Ashtonantony28/vla-arm/sim/README.md

# sim/ — MuJoCo twin, tasks, scripted experts, LeRobot recording

Everything here is generated from `spec/kinematics.yaml`; nothing in `sim/` hard-codes a link
length, joint limit, mass or servo rating.

## Setup

```bash
cd sim
python3 -m venv .venv                                   # gitignored
.venv/bin/pip install torch torchvision                  # see note on CPU wheels below
.venv/bin/pip install -r requirements.txt                # mujoco, lerobot[dataset,diffusion], pytest, ...
export MUJOCO_GL=egl                                     # offscreen rendering (conftest sets this)
```

What the build machine got (Python 3.13.18, 4 CPU cores, no GPU): mujoco 4.0.0, torch 2.15.0,
torchvision 0.29.2, lerobot 0.7.0 (+ datasets 5.1.0, diffusers 0.39.0, av 15.1.0, torchcodec 0.17.0),
numpy 2.2.6 (lerobot downgraded it from 2.5), gymnasium 1.4.0, pytest 9.2.0.

* `download.pytorch.org` is blocked on that machine, so the CPU-only wheel index was unusable and
  torch came from PyPI (the CUDA build, ~4 GB of `nvidia-*` libraries, runs fine on CPU). On a
  machine with access prefer `--index-url https://download.pytorch.org/whl/cpu`.
* EGL rendering needed `apt-get install libegl1 libegl-mesa0 libgl1-mesa-dri`; OSMesa did not work
  with this mujoco build, so stay with `MUJOCO_GL=egl`.

All commands below run from the repo root with `sim/.venv/bin/python`.

## Model — `sim/model/`

```bash
python -m sim.model.build_mjcf            # regenerate sim/model/vla_arm.xml from the spec
python -m sim.model.build_mjcf --check    # CI: fails if the XML is stale (also a pytest)
```

* Links: capsules/boxes with the spec masses (`masses_kg`; the gripper mass is split palm 70%,
  fingers 15% each). Joint axes, origins, limits from the spec. TCP site at `tool.tcp`.
* Actuators: MuJoCo `position` actuators, `forcerange = ±stall_torque_nm` (2.9 N·m),
  `kp = stall / 0.02 rad` (torque saturates after ~1.1° error, like the servo's P loop),
  critically-damped `kv`, armature 0.01 kg·m² (rotor inertia × gear ratio², ~1:345).
  The env ramps setpoints at sim rate and rate-limits them to the spec `vmax`.
* Gripper: two slide fingers coupled by an equality constraint; the actuator takes the servo angle
  (0 closed … 1.6 rad open) and maps it linearly to 0 … 60 mm jaw gap (`opening_m_at_max`). Its
  force limit is the *continuous* torque (stall × 1.0 A / 2.7 A = 1.07 N·m), on the assumption that
  the firmware limits holding current. TPU-like friction (1.5) on the fingers, elliptic cones.
* Scene: table plane at z = 0 (the base plate stands on it), red/blue 30 mm cubes (30 g, free),
  green/yellow bowls (mocap, repositioned each reset), a cup (free) and a target mark (visual).
  Objects a task doesn't use are parked off-table at x = 3 m.
* Cameras: `wrist` on the gripper body (behind the palm, pitched 40° toward the jaws, fovy 80) and
  a fixed `scene` camera front-right of the arm.
* Tests check: XML up to date, masses, zero-pose TCP = (0.490, 0, 0.100), each actuator moves its
  own joint in the documented positive direction (yaw +x→+y, pitch down, roll right-hand about x,
  gripper positive opens), FK (`sim/kinematics.py`) == MuJoCo, closed-form top-down IK round trip.

## Env — `sim/envs/`

```python
from sim.envs.tabletop import TabletopEnv
env = TabletopEnv("pick_place", image_size=96)          # "stack", "sort"; image_size int or (h, w)
obs, info = env.reset(seed=0)
obs, reward, terminated, truncated, info = env.step(action6)
```

* Observation: `observation.state` (6 joint positions, rad, order
  base_yaw, shoulder_pitch, elbow_pitch, wrist_pitch, wrist_roll, gripper),
  `observation.images.wrist|scene` (uint8 HxWx3), `task` (instruction string).
* Action: 6 absolute joint targets at 30 Hz; 20 physics substeps (dt = 1/600 s) in between.
* Tasks (`sim/envs/tasks.py`) with 5 paraphrases each; the first 3 are used for data, the last 2 are
  held out (`instruction_split="heldout"`):
  * `pick_place` — red block into the (green) bowl; blue block is a distractor.
  * `stack` — red block on the blue block.
  * `sort` — red and blue into the green/yellow bowls; the colour→bowl assignment is random and
    only given by the instruction (so the task needs language).
  * 30% of resets also place the cup and/or the target mark as distractors.
* Success: block centre inside the bowl's inner radius and below the rim; or red on blue within
  15 mm xy and 30 ± 6 mm z with blue on the table. In every case the block must not be touching
  the fingers (it was released).

## Domain randomisation — `sim/envs/randomization.py`

```python
env = TabletopEnv("pick_place", image_size=96, randomize="default")   # or "visual", a dict, a DRConfig
```

Applied at every `reset` by editing `MjModel` fields in place (no XML change):

| group | what | range (preset `default`) |
|---|---|---|
| lighting | key-light direction tilt, key / fill intensity, colour temperature, headlight | ≤ 25°, ×0.55–1.35, ×0.4–1.6, ±12 % per channel, ambient 0.2–0.5 / diffuse 0.3–0.65 |
| colours / textures | table tint (saturation ≤ 0.22 so it never reads as a task colour), checker repeat, arm shade; objects jittered **inside their colour class** (red H ±0.025, blue 0.58–0.66, green 0.29–0.40, yellow 0.12–0.16); cup / target random low-saturation | repeat 3–10, shade ×0.75–1.3 |
| camera | position jitter and rotation about a random axis | scene ±5 mm / ±2°, wrist ±2 mm / ±1.5° |
| action noise | Gaussian on the 5 arm joint targets inside `step` (the recorded action is the clean command, DART-style) | σ = 4 mrad (`visual` preset: 0) |

* DR draws come from their own streams seeded from the reset seed (`[seed, 0xD12]`, `[seed, 0xAC7]`),
  so for a given seed the **layout and instruction are identical with or without DR** — every
  policy and every DR setting is evaluated on the same start poses.
* All draws happen even for disabled groups, so toggling one group does not change the others.
* `env.dr_params` holds what was drawn (also saved per episode in `meta/sim_episodes.jsonl`).
* Tests (`sim/tests/test_randomization.py`): same seed → identical images/params, layouts
  independent of DR, nominal env untouched, colours stay in class over 60 seeds, camera/light
  bounds, seeded action noise, toggles independent.
* The experts are unaffected: `python -m sim.expert.evaluate --episodes 40 --randomize default`
  → pick_place / stack / sort 40/40 each (Wilson 95 % CI 91–100 %).

Contact sheet (rows: DR pick_place, DR sort, nominal; seeds 900000–900005):
`outputs/wave2/viz/dr_sheet.png` (not in git).

## Scripted experts — `sim/expert/`

Privileged-state experts: Cartesian waypoints (approach → descend → close → lift → transfer → lower
→ open → retreat), min-jerk interpolation, closed-form IK, jaw aligned to the nearest cube face,
noise on waypoints (2–4 mm), segment durations (±15%) and joint targets (σ = 0.002 rad).

```bash
python -m sim.expert.evaluate --episodes 100
```

Result (seeds 0–99): pick_place 100/100, stack 100/100, sort 100/100
(Wilson 95% CI 96–100% each); mean 168 / 168 / 356 steps.

## Recording — `sim/record.py`

```bash
python -m sim.record --task all --episodes 30 --image-size 96 --overwrite
# wave 2: domain-randomised data (two halves recorded in parallel, plus a validation set)
python -m sim.record --task pick_place --episodes 50 --randomize default --root outputs/wave2/datasets --name-suffix _dr_a
python -m sim.record --task pick_place --episodes 50 --randomize default --seed0 1000 --root outputs/wave2/datasets --name-suffix _dr_b
python -m sim.record --task pick_place --episodes 10 --randomize default --seed0 950000 --root outputs/wave2/datasets --name-suffix _dr_val
```

Uses LeRobot's own `LeRobotDataset.create / add_frame / save_episode / finalize` (dataset format
**v3.0**: chunked parquet + AV1 MP4 per camera, `meta/info.json`, `meta/stats.json`,
`meta/tasks.parquet`, `meta/episodes/`). Extra sidecars: `meta/sim_episodes.jsonl` (seed, layout,
instruction per episode) and `meta/sim_record_summary.json`. Only successful episodes are kept;
10 frames after success are kept so policies learn to stop. Recording seeds start at 0, eval
seeds at 900 000.

Recorded on the build machine into `outputs/datasets/` (gitignored), 96×96:

| dataset | episodes | frames | size | time |
|---|---|---|---|---|
| vla_arm_sim_pick_place | 30 | 5 333 | 11.4 MB | 4.6 min |
| vla_arm_sim_stack | 30 | 5 332 | 10.1 MB | 4.1 min |
| vla_arm_sim_sort | 30 | 11 014 | 25.1 MB | 10.3 min |

Wave 2, domain-randomised (`--randomize default`), into `outputs/wave2/datasets/` (times are with
3 recorders sharing the CPU; EGL uses llvmpipe software rendering here, ~1.1 cores per recorder):

| dataset | episodes (seeds) | frames | size | time |
|---|---|---|---|---|
| vla_arm_sim_pick_place_dr_a | 50 (0–49) | 8 899 | 17.3 MB | 15.7 min |
| vla_arm_sim_pick_place_dr_b | 50 (1000–1049) | 8 899 | 17.1 MB | 15.8 min |
| vla_arm_sim_pick_place_dr_val | 10 (950000–) | 1 800 | 3.5 MB | 3.0 min |
| vla_arm_sim_pick_place_val (nominal) | 10 (950000–) | 1 799 | 3.9 MB | 3.1 min |
| vla_arm_sim_sort_dr | 100 (0–99) | 36 648 | 76.6 MB | 65.8 min |

(`vla_arm_sim_pick_place_dr` in that folder is an aborted, unfinalised recording; ignore it.)

## Tests

```bash
sim/.venv/bin/python -m pytest -q sim/tests policies/tests
```

## Real vs simplified

* Real: geometry, limits, masses, stall torque, vmax from the spec; contact physics; cameras.
* Simplified: link shapes are primitives; servo = ideal saturating PD (no backlash, deadband,
  compliance, temperature); gripper linkage is linear; the expert uses privileged object poses;
  bowls are fixed during an episode; domain randomisation covers lighting, colours, camera pose
  and action noise but not object size/mass/friction, textures beyond a tinted checker, or
  camera intrinsics.
