Ashtonantony28/vla-arm/hardware/board/out/erc_report.md

# Board ERC report (generated by `python -m board.generate`)

Netlist: 139 parts, 68 nets, 358 pin connections, 9 ICs.

## Own ERC (board/erc.py): 0 errors, 7 warnings

- no errors
- warning R5: UNVERIFIED mapping PB14 = USART3_DE (RTS/DE, DEM=1) (AF7): hardware driver-enable: high during TX; drives both buffer OEs. If not available, use PB14 as GPIO toggled in the TC interrupt
- warning R5: UNVERIFIED mapping PA11 = USB_DM (USB (fixed pin)): USB FS pins are fixed; confirm in RM0440 whether an AF selection is needed (CubeMX does it)
- warning R5: UNVERIFIED mapping PA12 = USB_DP (USB (fixed pin)): internal DP pull-up, no external 1.5k
- warning R5: UNVERIFIED mapping PB12 = FDCAN2_RX (AF9): FDCAN1 is avoided: PA11/12 clash with USB, PB8 is BOOT0 (CAN RXD idles high -> would boot ROM)
- warning R5: UNVERIFIED mapping PB13 = FDCAN2_TX (AF9): 
- warning R5: UNVERIFIED mapping PC0 = ADC12_IN6 (analog): board NTC
- warning R5: UNVERIFIED mapping PC1 = ADC12_IN7 (analog): protected 12 V divider 100k/15k

## SKiDL built-in ERC: 0 errors, 26 warnings

- 26 warnings = unused STM32 GPIOs left unconnected (intended; spare pins, route to a header or leave as NC in KiCad)

## BOM lines needing a human check: 22 of 89

- C3 C4 C39 C40: Electrolytic 470 uF 25 V low-ESR, radial 10 mm -> Panasonic EEU-FR1E471 [verify]
- D6: ESD/TVS 5 V unidirectional (servo data line) -> Nexperia PESD5V0S1BL [verify]
- D7: Zener 15 V gate clamp -> Diodes Inc BZT52C15-7-F [verify]
- D9: CAN bus ESD protection -> Nexperia PESD2CAN,215 [verify]
- F1: Fuse 15 A slow-blow, >= 32 V (or blade fuse in the PSU lead) ->  (no part chosen) [TBD]
- J1: 12 V input, XT30 PCB male (rated 15 A+) -> Amass XT30PW-M [verify]
- J2: Cortex-M 10-pin SWD header 1.27 mm -> Samtec FTSH-105-01-F-DV-K [verify]
- J4: USB-C receptacle, USB 2.0 device -> GCT USB4105-GF-A [verify]
- J5: Servo bus port, 3-pin (match the servo cable: pin order and housing MUST be checked against the STS3215 lead) ->  (no part chosen) [TBD]
- J6: Servo bus port, 3-pin (match the servo cable: pin order and housing MUST be checked against the STS3215 lead) ->  (no part chosen) [TBD]
- J7: Servo bus port, 3-pin (match the servo cable: pin order and housing MUST be checked against the STS3215 lead) ->  (no part chosen) [TBD]
- J9: CAN-FD port (v2), JST-GH 3p -> JST SM03B-GHS-TB(LF)(SN) [verify]
- L1: Inductor ~10 uH, Isat >= 4 A, DCR < 40 mOhm (TPS54331 5 V/3 A) ->  (no part chosen) [TBD]
- L2: Inductor 2.2 uH, Isat >= 1.5 A -> Murata DFE201610E-2R2M [verify]
- Q1: N-MOSFET 30 V, < 3 mOhm, SON5x6 (ideal-diode pass FET) -> TI CSD17573Q5B [verify]
- Q2: P-MOSFET -40 V, ~15 mOhm, Id >= 30 A, DPAK (servo power switch) -> Alpha & Omega AOD4185 [verify]
- Q3 Q4: N-MOSFET logic level 50 V 200 mA SOT-23 -> onsemi BSS138LT1G [verify]
- R_SH: Current shunt 3 mOhm 1 % 2 W 2512, Kelvin pads -> Vishay WSL2512R0030FEA [verify]
- SW1: Tactile switch SMD -> C&K PTS810SJM250SMTRLFS [verify]
- SW2: Tactile switch SMD -> C&K PTS810SJM250SMTRLFS [verify]
- U9: CAN-FD transceiver with VIO (8 Mbps, SIC) - v2 joint modules -> TI TCAN1462VDRQ1 [verify]
- Y1: Crystal 24 MHz, CL 8-10 pF, +-20 ppm, 3225 -> Abracon ABM8-24.000MHZ-B2-T [verify]
