Ashtonantony28/vla-arm/hardware/cad/out/cad_report.md

# CAD check report (generated by `python -m cad.build`; do not edit)

Generated 2026-11-06. All numbers come from the generated B-rep, not from hand calculation. Nothing here has been printed or measured.

## Printed parts

| part | link | mat | valid closed solid | volume cm3 | est. mass g | bbox mm | fits 220x220x250 | min wall mm (1st pct) | STL kB |
|---|---|---|---|---|---|---|---|---|---|
| base | base | PETG | yes | 233.2 | 118.5 | 140 x 190 x 40 | yes (height 140.0 mm, footprint 190.0 x 39.6 rotated 0.0 deg) | 2.00 (3.45) | 108 |
| shoulder_bracket | shoulder | PETG | yes | 85.7 | 43.6 | 72 x 72 x 117 | yes (height 72.0 mm, footprint 72.1 x 117.4 rotated 0.0 deg) | 2.30 (2.30) | 153 |
| upper_arm | upper_arm | PETG | yes | 85.7 | 43.5 | 252 x 62 x 52 | yes (height 62.0 mm, footprint 251.8 x 52.1 rotated 43.0 deg) | 2.50 (2.50) | 175 |
| forearm | forearm | PETG | yes | 76.7 | 39.0 | 232 x 50 x 52 | yes (height 231.8 mm, footprint 50.0 x 52.0 rotated 0.0 deg) | 2.50 (2.50) | 188 |
| wrist_bracket | wrist | PETG | yes | 28.2 | 14.3 | 71 x 49 x 52 | yes (height 71.0 mm, footprint 49.1 x 52.1 rotated 0.0 deg) | 2.70 (2.72) | 158 |
| gripper_body | gripper | PETG | yes | 40.1 | 20.4 | 46 x 80 x 72 | yes (height 46.0 mm, footprint 80.0 x 72.4 rotated 0.0 deg) | 2.00 (2.50) | 42 |
| camera_mount | gripper | PETG | yes | 18.6 | 9.4 | 28 x 36 x 34 | yes (height 28.0 mm, footprint 36.0 x 34.0 rotated 0.0 deg) | 2.90 (2.91) | 80 |
| pinion | grip_drive | PETG | yes | 7.1 | 3.6 | 7 x 40 x 40 | yes (height 7.0 mm, footprint 40.4 x 40.5 rotated 0.0 deg) | 2.70 (2.72) | 82 |
| jaw_a | jaw_a | PETG | yes | 6.2 | 3.2 | 37 x 44 x 22 | yes (height 37.0 mm, footprint 44.0 x 21.9 rotated 0.0 deg) | 6.00 (6.00) | 9 |
| jaw_b | jaw_b | PETG | yes | 13.9 | 7.1 | 37 x 44 x 66 | yes (height 37.0 mm, footprint 44.0 x 65.9 rotated 0.0 deg) | 6.00 (6.00) | 9 |
| pad_a | jaw_a | TPU | yes | 0.8 | 1.0 | 20 x 2 x 20 | yes (height 20.0 mm, footprint 2.0 x 20.0 rotated 0.0 deg) | 2.00 (2.00) | 1 |
| pad_b | jaw_b | TPU | yes | 0.8 | 1.0 | 20 x 2 x 20 | yes (height 20.0 mm, footprint 2.0 x 20.0 rotated 0.0 deg) | 2.00 (2.00) | 1 |

Total printed mass estimate: **304 g** (PETG 1.27 g/cm3 x 40% effective solid fraction; TPU pads solid).

## Link masses vs spec (g)

| link | printed | servos + purchased | total | spec | delta |
|---|---|---|---|---|---|
| base | 118 | 165 | 283 | 350 | -67 |
| shoulder | 44 | 55 | 99 | 110 | -11 |
| upper_arm | 44 | 55 | 99 | 140 | -41 |
| forearm | 39 | 55 | 94 | 120 | -26 |
| wrist | 14 | 0 | 14 | 75 | -61 |
| gripper | 46 | 125 | 171 | 110 | +61 |
| **all** | | | **760** | **905** | -145 |

Note: in this design the wrist-roll servo CASE rides in the gripper (its horn is bolted to the wrist bracket), so mass moves from `wrist` to `gripper`; wrist+gripper = 185 g vs spec 185 g. Fasteners, wiring and heat-set inserts are not included (budget +5-10 % per link).

## Joint-axis distances measured from part geometry

| feature pair | measured mm | spec mm | error mm |
|---|---|---|---|
| base: plate -> yaw horn face | 40.000 | 40.000 | +0.000 |
| shoulder bracket: yaw horn face -> shoulder axis | 60.000 | 60.000 | +0.000 |
| upper_arm: proximal bore axis -> distal stub axis | 200.000 | 200.000 | +0.000 |
| forearm: proximal bore axis -> distal stub axis | 180.000 | 180.000 | +0.000 |
| wrist bracket: pitch axis -> roll horn face | 45.000 | 45.000 | +0.000 |
| gripper: roll horn face -> TCP (pad centre) | 65.000 | 65.000 | +0.000 |

## Collision-free joint ranges (one joint swept, others at zero)

Adjacent = parent/child parts across the swept joint (incl. servo cases, horns, bearing). All = every part downstream of the joint vs every part upstream.

| joint | spec limits rad | adjacent-pair free range | all-pairs free range | within spec? |
|---|---|---|---|---|
| base_yaw | [-2.60, +2.60] | [-2.600, +2.600] | [-2.600, +2.600] | yes |
| shoulder_pitch | [-1.80, +1.30] | [-1.800, +0.843] | [-1.800, +0.802] | **NO** |
| elbow_pitch | [-2.70, +2.70] | [-2.700, +2.700] | [-2.700, +2.363] | yes |
| wrist_pitch | [-1.90, +1.90] | [-1.900, +1.900] | [-1.900, +1.900] | yes |
| wrist_roll | [-3.00, +3.00] | [-3.000, +3.000] | [-3.000, +3.000] | yes |
| gripper | [+0.00, +1.60] | [+0.000, +1.600] | [+0.000, +1.600] | yes |

Shoulder: with the shoulder axis only 100 mm above the plate (spec) and the base housing the yaw servo under a 78 mm bearing, the upper arm reaches the base/turntable at about +0.80 rad (46 deg down); the spec limit +1.30 rad is not mechanically reachable. Elbow: folding down past ~+2.36 rad with the shoulder at zero drives the wrist into the base (a pose-dependent self-collision for the host-side checker, not an adjacent-part clash).
