Ashtonantony28/vla-arm/hardware/cad/out/camera_mount.stl

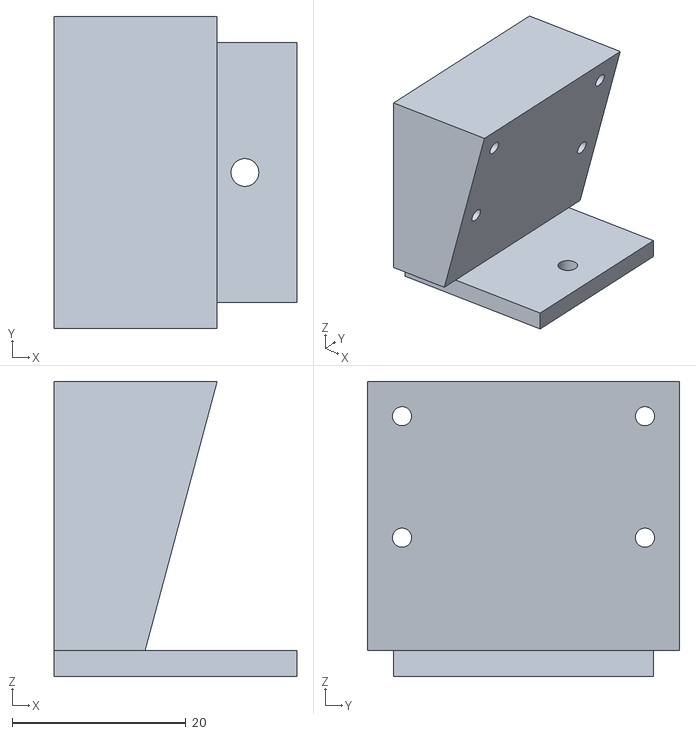
[picture p1: CAD file, 2026-11-06]
hardware/cad/out/camera_mount.stl
28.0 x 36.0 x 34.0
