Ashtonantony28/vla-arm/hardware/cad/out/upper_arm.stl

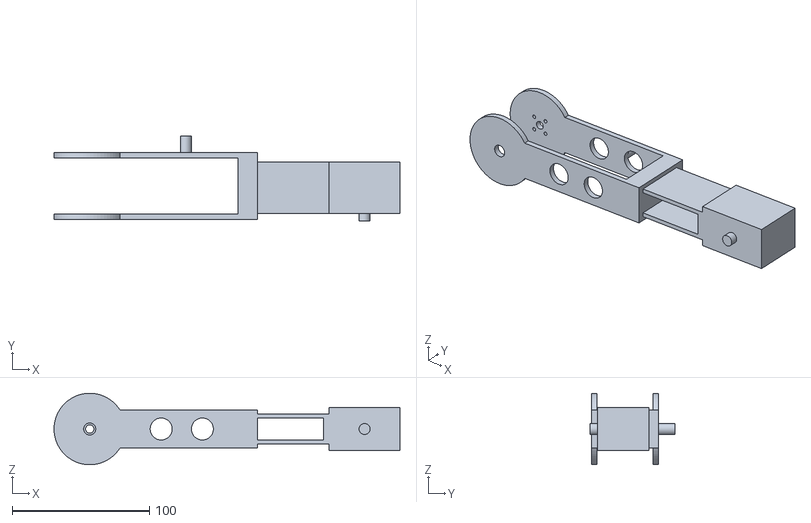
[picture p2: CAD file, 2026-11-06]
hardware/cad/out/upper_arm.stl
251.8 x 62.0 x 52.0
