Ashtonantony28/vla-arm/hardware/cad/out/shoulder_bracket.stl

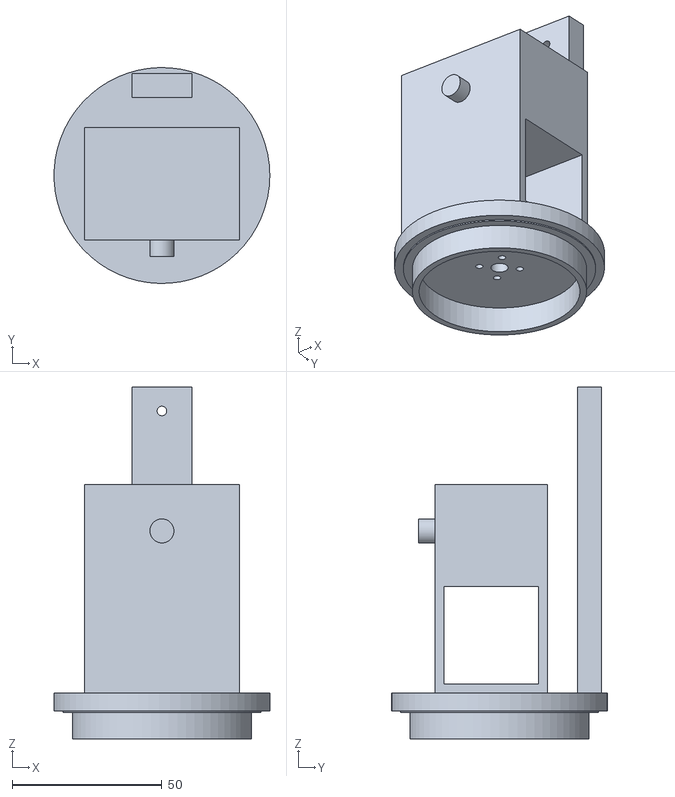
[picture p3: CAD file, 2026-11-06]
hardware/cad/out/shoulder_bracket.stl
72.0 x 72.0 x 117.4
