Ashtonantony28/vla-arm/hardware/cad/out/pad_a.stl

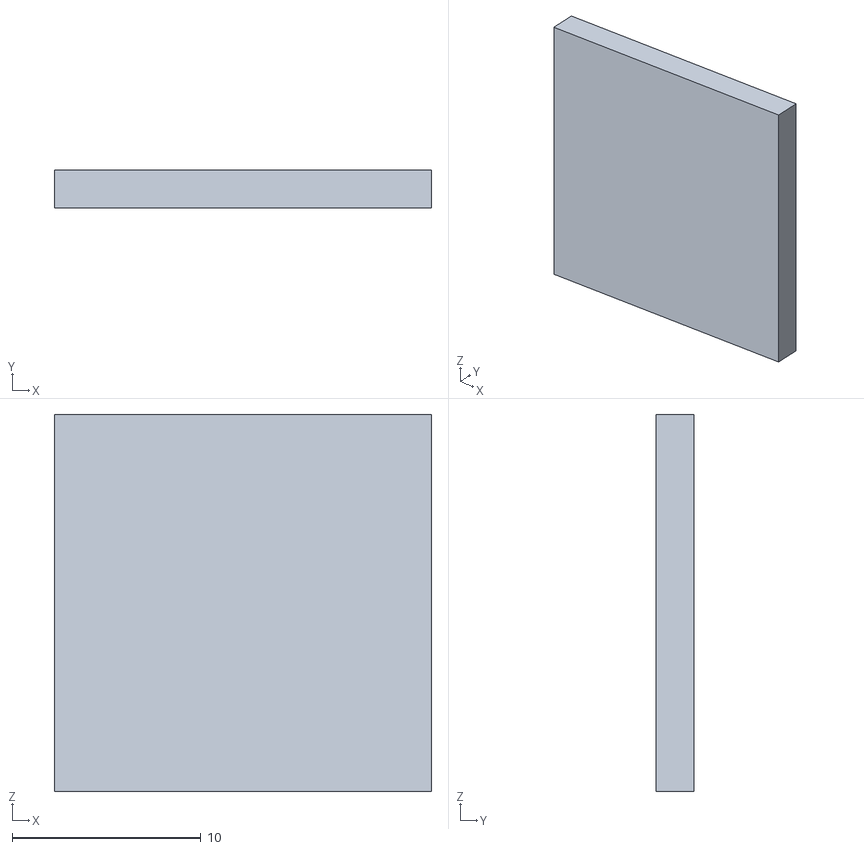
[picture p4: CAD file, 2026-11-06]
hardware/cad/out/pad_a.stl
20.0 x 2.00 x 20.0
