Ashtonantony28/vla-arm/hardware/cad/out/wrist_bracket.stl

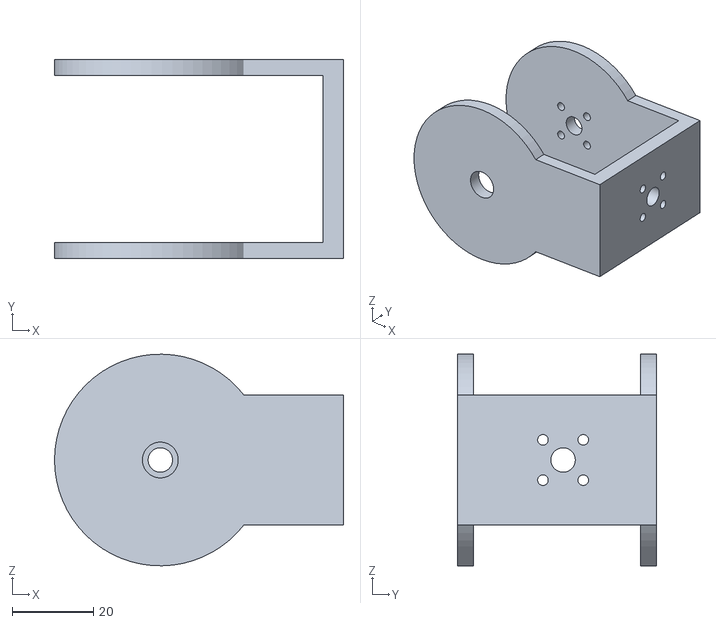
[picture p5: CAD file, 2026-11-06]
hardware/cad/out/wrist_bracket.stl
71.0 x 49.0 x 52.0
