Ashtonantony28/vla-arm/hardware/cad/out/jaw_b.stl

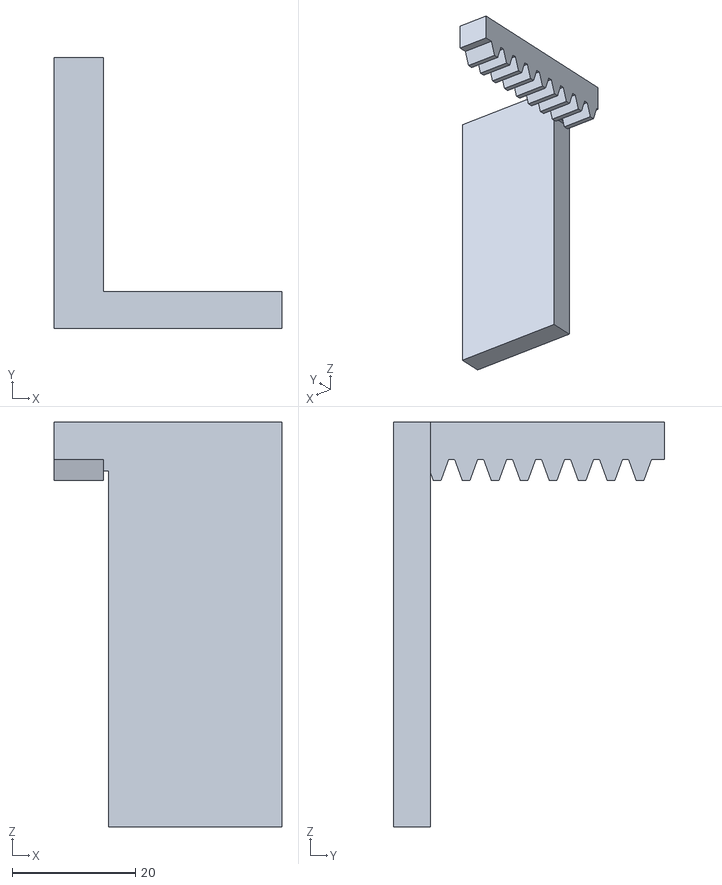
[picture p6: CAD file, 2026-11-06]
hardware/cad/out/jaw_b.stl
37.0 x 44.0 x 65.8
