Ashtonantony28/vla-arm/hardware/cad/out/pinion.stl

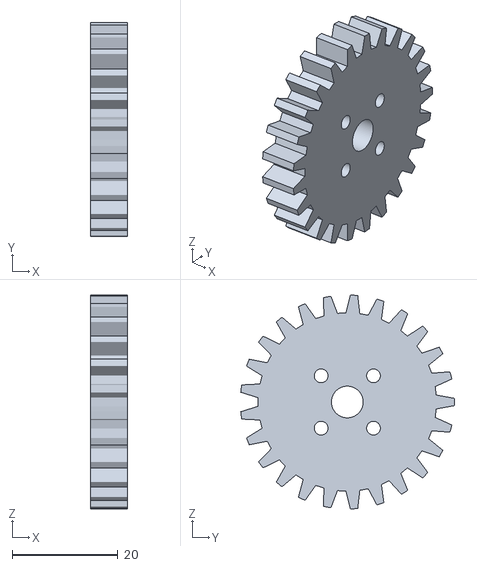
[picture p7: CAD file, 2026-11-06]
hardware/cad/out/pinion.stl
7.00 x 40.4 x 40.5
