Ashtonantony28/vla-arm/hardware/cad/out/forearm.stl

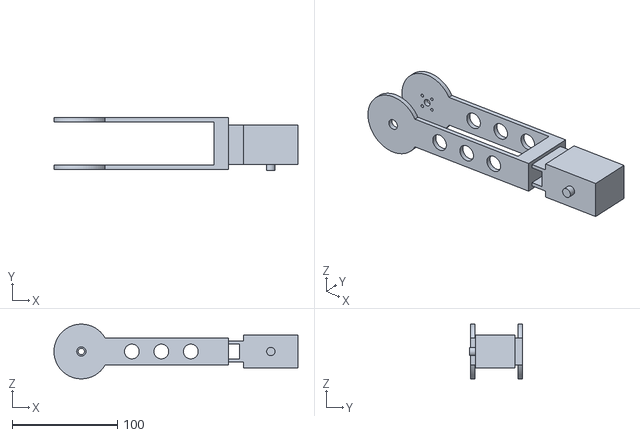
[picture p8: CAD file, 2026-11-06]
hardware/cad/out/forearm.stl
231.8 x 50.0 x 52.0
