Ashtonantony28/vla-arm/hardware/cad/out/base.stl

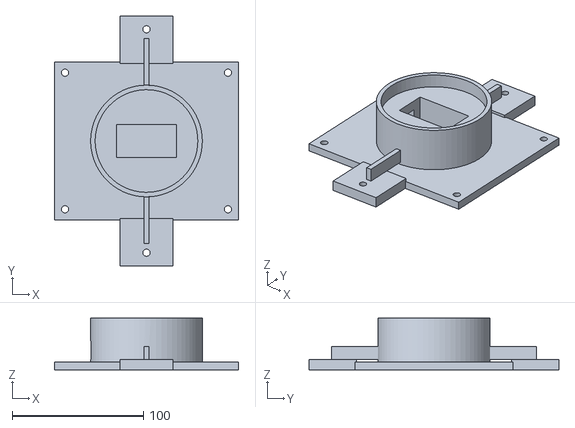
[picture p9: CAD file, 2026-11-06]
hardware/cad/out/base.stl
140.0 x 190.0 x 39.5
