Ashtonantony28/vla-arm/hardware/cad/out/gripper_body.stl

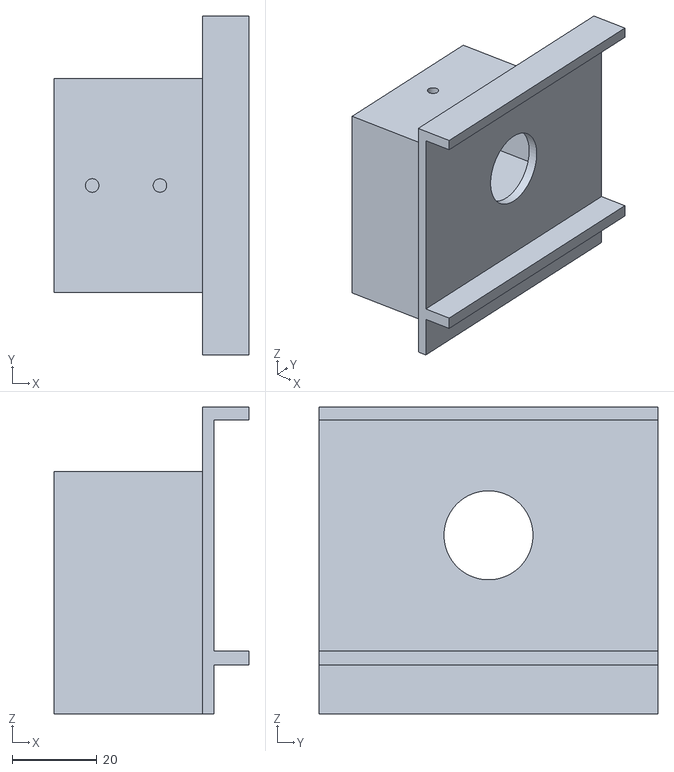
[picture p10: CAD file, 2026-11-06]
hardware/cad/out/gripper_body.stl
46.0 x 80.0 x 72.4
