Ashtonantony28/vla-arm/hardware/cad/out/jaw_a.stl

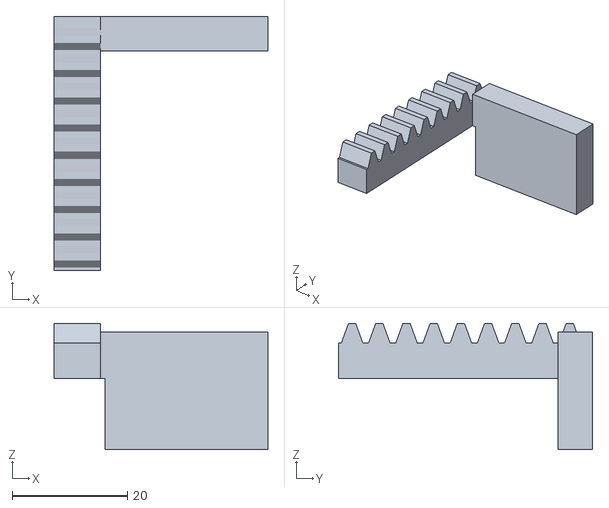
[picture p11: CAD file, 2026-11-06]
hardware/cad/out/jaw_a.stl
37.0 x 44.0 x 21.9
