Ashtonantony28/vla-arm/(list of files, cad)

Other CAD files:
hardware/cad/out/pad_b.stl
