Ashtonantony28/vla-arm/firmware/targets/stm32g474/tusb_config.h

/* TinyUSB configuration: device only, full speed, one CDC-ACM interface (the host link). */
#ifndef TUSB_CONFIG_H
#define TUSB_CONFIG_H

#define CFG_TUSB_MCU OPT_MCU_STM32G4
#define CFG_TUSB_OS OPT_OS_NONE
#define CFG_TUSB_DEBUG 0
#define CFG_TUSB_MEM_SECTION
#define CFG_TUSB_MEM_ALIGN __attribute__((aligned(4)))

#define BOARD_TUD_RHPORT 0
#define CFG_TUD_ENABLED 1
#define CFG_TUD_MAX_SPEED OPT_MODE_FULL_SPEED
#define CFG_TUD_ENDPOINT0_SIZE 64

#define CFG_TUD_CDC 1
#define CFG_TUD_MSC 0
#define CFG_TUD_HID 0
#define CFG_TUD_MIDI 0
#define CFG_TUD_VENDOR 0

/* CDC FIFOs inside TinyUSB. The firmware's own rings (host_link) sit behind these. */
#define CFG_TUD_CDC_RX_BUFSIZE 512
#define CFG_TUD_CDC_TX_BUFSIZE 1024
#define CFG_TUD_CDC_EP_BUFSIZE 64

#endif
