Ashtonantony28/vla-arm/hardware/tests/test_cad.py

"""Automated checks on the generated CAD (geometry from the B-rep, kinematics from spec/)."""
import numpy as np
import pytest

from cad import assembly as A
from cad import checks as C
from cad import params as P
from cad import parts as PT
from spec_loader import load_spec

PRINTED = list(PT.PRINTED)


@pytest.mark.parametrize("teeth", [False, True])
@pytest.mark.parametrize("name", PRINTED)
def test_part_is_single_valid_closed_solid(name, teeth):
    r = C.solid_report(PT.build_printed(name, teeth))
    assert r["n_solids"] == 1 and r["valid"] and r["closed"] and r["volume"] > 0


@pytest.mark.parametrize("name", PRINTED)
def test_part_fits_print_bed(name):
    ok, how = C.fits_bed(PT.build_printed(name, teeth=True))
    assert ok, how


@pytest.mark.parametrize("name", PRINTED)
def test_min_wall_thickness(name):
    # pitch-envelope variant: gear teeth are excluded from the 2 mm rule by design
    wt = C.wall_thickness(PT.build_printed(name, teeth=False))
    assert wt["min"] >= P.WALL_MIN - 0.01, wt


def test_measured_joint_distances_match_spec():
    for k, (meas, spec) in C.measured_dimensions().items():
        assert abs(meas - spec) <= 0.5, (k, meas, spec)


def test_assembled_axes_match_spec_fk():
    """Place each part's measured axis features with the spec FK and compare consecutive distances."""
    spec = load_spec()
    pts = C.assembled_axes({})
    chain = ["shoulder_pitch", "elbow_pitch", "wrist_pitch", "wrist_roll", "tcp"]
    expected = [200.0, 180.0, 45.0, 65.0]
    for (a, b), e in zip(zip(chain, chain[1:]), expected):
        pa, pb = pts[a].copy(), pts[b].copy()
        pa[1] = pb[1] = 0.0          # pitch stubs sit on the idler side (y offset), axes are along y
        assert abs(np.linalg.norm(pb - pa) - e) <= 0.5, (a, b)
    # shoulder axis height above the base plate
    assert abs(pts["shoulder_pitch"][2] - 100.0) <= 0.5
    # also in a non-trivial pose: TCP from parts == TCP from spec chain
    q = {"base_yaw": 0.7, "shoulder_pitch": -0.6, "elbow_pitch": 1.1, "wrist_pitch": 0.4, "wrist_roll": 1.0}
    p = C.assembled_axes(q)
    assert np.allclose(p["tcp"], A.tcp_world(q), atol=0.5)


def test_tcp_zero_pose_matches_spec():
    s = load_spec()
    x = 1000 * (sum(j["origin"][0] for j in s["joints"]) + s["tool"]["tcp"][0])
    z = 1000 * sum(j["origin"][2] for j in s["joints"])
    assert np.allclose(A.tcp_world({}), [x, 0, z], atol=1e-6)


def test_gripper_opening_matches_spec():
    """Pad-to-pad gap measured from posed parts at full open equals spec opening_m_at_max."""
    hi = load_spec()["gripper"]["limits"][1]
    pads = {it.name: s for it, s in A.posed({"gripper": hi}) if it.name in ("pad_a", "pad_b")}
    gap = pads["pad_a"].BoundingBox().ymin - pads["pad_b"].BoundingBox().ymax
    assert gap == pytest.approx(1000 * load_spec()["gripper"]["opening_m_at_max"], abs=0.5)


def test_zero_pose_no_interference_any_pair():
    assert A.collisions({}, adjacent_only=False) == []


@pytest.mark.parametrize("jn", ["base_yaw", "elbow_pitch", "wrist_pitch", "wrist_roll", "gripper"])
def test_sweep_spec_limits_adjacent_clear(jn):
    bad = [(q, h) for q, h in C.sweep(jn, n=13, adjacent_only=True) if h]
    assert not bad, bad


def test_shoulder_sweep_clear_within_mechanical_range():
    lo = C.joint_limits()["shoulder_pitch"][0]
    for q in np.linspace(lo, 0.80, 14):
        assert A.collisions({"shoulder_pitch": q}, C.moving_set("shoulder_pitch"), adjacent_only=False) == [], q


# spec v1.1 lowered shoulder max to +0.75 rad (was +1.30, which hit the base at ~+0.80)
def test_shoulder_sweep_spec_limits_adjacent_clear():
    bad = [(q, h) for q, h in C.sweep("shoulder_pitch", n=13, adjacent_only=True) if h]
    assert not bad


def test_sweep_all_pairs_known_self_collisions_only():
    """Non-adjacent clashes during single-joint sweeps are limited to the known pose-dependent ones."""
    for jn in ("base_yaw", "wrist_pitch", "wrist_roll", "gripper"):
        assert all(not h for _, h in C.sweep(jn, n=9, adjacent_only=False)), jn
    lo, hi = C.free_range("elbow_pitch", adjacent_only=False)
    assert lo == C.joint_limits()["elbow_pitch"][0] and 2.2 < hi < 2.7


def test_pinion_tangent_to_racks_over_stroke():
    """Pitch-envelope pinion stays tangent (no overlap, no gap > 0.05 mm) to both racks over the stroke."""
    def rack_face(shape, x_max, up):
        zs = [f.Center().z for f in shape.Faces() if f.geomType() == "PLANE" and f.BoundingBox().xmin < x_max
              and f.normalAt(f.Center()).z * (1 if up else -1) > 0.99]
        return max(zs) if up else min(zs)
    for qg in np.linspace(0, 1.6, 5):
        q = {"gripper": qg}
        x_max = A.link_transforms(q)["gripper"][0, 3] + P.RACK_X[1] - 0.5
        posed = {it.name: s for it, s in A.posed(q)}
        pin = posed["pinion"].BoundingBox()
        assert rack_face(posed["jaw_a"], x_max, up=True) == pytest.approx(pin.zmin, abs=0.05)
        assert rack_face(posed["jaw_b"], x_max, up=False) == pytest.approx(pin.zmax, abs=0.05)
        assert A.intersection_volume(posed["pinion"], posed["jaw_a"]) < 1.0


def test_mass_estimate_vs_spec():
    lm = C.link_masses()
    total = sum(v["total"] for v in lm.values())
    spec_total = sum(v["spec"] for v in lm.values())
    # spec masses (used for the torque budget) must not be optimistic for the long links
    for k in ("upper_arm", "forearm"):
        assert lm[k]["total"] <= lm[k]["spec"], k
    # wrist + gripper together within 15 % of spec (mass moves between them in this design)
    wg = lm["wrist"]["total"] + lm["gripper"]["total"]
    assert abs(wg - (lm["wrist"]["spec"] + lm["gripper"]["spec"])) / wg < 0.15
    assert total <= spec_total


def test_counterbalance_pin_clears_post_over_full_shoulder_range():
    for q in np.linspace(*C.joint_limits()["shoulder_pitch"], 25):
        posed = {it.name: s for it, s in A.posed({"shoulder_pitch": q})}
        # pin B lives on the upper arm, post on the shoulder bracket: their intersection volume must be 0
        assert A.intersection_volume(posed["upper_arm"], posed["shoulder_bracket"]) < 1.0 or q > 0.80
