Ashtonantony28/vla-arm/(commit log)

2026-11-06 spec: kinematics, board protocol v1, locked decisions
    Claude-Session: https://claude.ai/code/session_01VH3Aye1GYbFVrQh2pPcUzc
2026-11-06 armctl: host driver, kinematics/IK, safety shim, calibration, mock board, teleop (90 tests)
    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
2026-11-06 WIP: firmware, sim, policies, hardware as of rate-limit stop (untested)
    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
    [assembly_zero_pose.step, base.step, base.stl, camera_mount.step, camera_mount.stl, forearm.step, forearm.stl, gripper_body.step]
2026-11-06 firmware: portable core, sim harness, libarmfw, STM32G474 target skeleton (96 tests, ASan/UBSan clean)
    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
2026-11-06 hardware: CAD, torque/power budget, controller board netlist (85 tests); armctl<->firmware cross-test
    Cross-test found that the firmware NACKs torque-enable for ~6 ms after boot; ArmClient.enable
    now retries in exactly that case.
    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
    [assembly_zero_pose.step, base.step, bom.csv, camera_mount.step, forearm.step, gripper_body.step, jaw_a.step, jaw_b.step]
2026-11-06 spec v1.1: tighten shoulder/elbow limits, 0.20 kg payload, protocol clarifications
    Limits propagated to firmware defaults, MJCF regenerated, tests updated.
    All suites green; expert still 50/50 on every task under the new limits.
    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
    [config.c, kinematics.yaml, test_cad.py, test_config.c, test_control.c]
2026-11-11 Firmware wave 2: ADC sensing, power-loss-safe calibration flash, USB CDC host link (#2)
    * firmware/third_party: vendor TinyUSB 0.21.0, ST CMSIS G4 v1.2.6, CMSIS-Core 5.9.0 (trimmed)
    Only the files the STM32G474 build needs, plus each licence (MIT / Apache-2.0):
    - tinyusb: core, device stack, CDC class, STM32 FSDEV device driver
    - cmsis_device_g4: stm32g4xx.h, stm32g474xx.h, system_stm32g4xx.h
    - cmsis_5: core_cm4.h and its compiler/version/MPU headers
    fetch.sh re-creates the tree from the pinned tags (2.2 MB, 44 files).
    * firmware: ADC path, power-loss-safe calib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
2026-11-11 armctl wave 2: collision model, firmware-faithful path checks, LeRobot integration (#3)
    * armctl: capsule collision model fitted to the CAD (self, base, table)
    41 capsules over 7 moving links (shoulder bracket, upper arm, forearm, wrist
    bracket, gripper body, jaw A/B with the jaw shift following the gripper angle)
    plus static boxes/cylinders for the base and turntable, in
    armctl/data/collision_model.yaml. Radii are fitted, not guessed:
    tools/dump_cad_links.py tessellates every CAD item per link (hardware venv),
    tools/fit_capsules.py takes the max distance per capsule so every CAD point
    is enclosed (0 outside).
    Vectorised over a batch of poses with bounding-sphere culling; capsule-capsule
    e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
    [client.py, collision.py]
2026-11-11 Sim/ML wave 2: domain randomisation, from-scratch ACT to 25% held-out, ACT vs DP, language run (#4)
    * sim: seeded domain randomisation (lighting, colours within class, camera jitter, action noise)
    Applied by editing MjModel fields at reset from streams separate from the layout
    stream, so a seed gives the same layout/instruction with or without DR. Expert
    stays 40/40 on all tasks under the 'default' preset (4 mrad action noise).
    sim.record / sim.expert.evaluate take --randomize. 9 new tests.
    * policies: from-scratch SmallCNN backbone, EE-position state, colour jit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
